ngocphan871/GATEWAY_AVIET_V1/Core/Inc/main.h

#define RELAY1_Pin GPIO_PIN_2
#define RELAY1_GPIO_Port GPIOE
#define RELAY2_Pin GPIO_PIN_3
#define RELAY2_GPIO_Port GPIOE
#define INPUT1_Pin GPIO_PIN_4
#define INPUT1_GPIO_Port GPIOE
#define INPUT2_Pin GPIO_PIN_5
#define INPUT2_GPIO_Port GPIOE
#define INPUT3_Pin GPIO_PIN_6
#define INPUT3_GPIO_Port GPIOE
#define RS485_DE_Pin GPIO_PIN_2
#define RS485_DE_GPIO_Port GPIOA
#define FLASH_CS_Pin GPIO_PIN_4
#define FLASH_CS_GPIO_Port GPIOA
#define FLOW1_Pin GPIO_PIN_0
#define FLOW1_GPIO_Port GPIOB
#define FLOW1_EXTI_IRQn EXTI0_IRQn
#define FLOW2_Pin GPIO_PIN_1
#define FLOW2_GPIO_Port GPIOB
#define FLOW2_EXTI_IRQn EXTI1_IRQn
#define TFT_RESET_Pin GPIO_PIN_12
#define TFT_RESET_GPIO_Port GPIOB
#define TFT_DC_Pin GPIO_PIN_14
#define TFT_DC_GPIO_Port GPIOB
#define TFT_CS_Pin GPIO_PIN_8
#define TFT_CS_GPIO_Port GPIOD
#define TFT_LED_Pin GPIO_PIN_9
#define TFT_LED_GPIO_Port GPIOD
#define RF_VCC1_Pin GPIO_PIN_9
#define RF_VCC1_GPIO_Port GPIOC
#define RF_BUSY_Pin GPIO_PIN_8
#define RF_BUSY_GPIO_Port GPIOA
#define RF_DIO1_Pin GPIO_PIN_9
#define RF_DIO1_GPIO_Port GPIOA
#define RF_VCC2_Pin GPIO_PIN_10
#define RF_VCC2_GPIO_Port GPIOA
#define RF_NSS_Pin GPIO_PIN_15
#define RF_NSS_GPIO_Port GPIOA
#define RF_DIO2_Pin GPIO_PIN_0
#define RF_DIO2_GPIO_Port GPIOD
#define RF_NRST_Pin GPIO_PIN_1
#define RF_NRST_GPIO_Port GPIOD
#define SIM_NETSTATUS_Pin GPIO_PIN_2
#define SIM_NETSTATUS_GPIO_Port GPIOD
#define SIM_STATUS_Pin GPIO_PIN_3
#define SIM_STATUS_GPIO_Port GPIOD
#define SIM_RESET_Pin GPIO_PIN_4
#define SIM_RESET_GPIO_Port GPIOD
#define SIM_PWRKEY_Pin GPIO_PIN_7
#define SIM_PWRKEY_GPIO_Port GPIOD
#define LED_Y4_Pin GPIO_PIN_3
#define LED_Y4_GPIO_Port GPIOB
