ngocphan871/GATEWAY_AVIET_V1/(commit log)

2026-10-19 add schematic pdf
2026-10-19 Firmware gateway V1: driver cho toan bo board + ung dung
    Cau hinh CubeMX (.ioc va code sinh ra) sua cho khop so do 2_GETWAY_V1:
    - Clock HSE 8 MHz -> PLL 168 MHz (truoc la HSI 16 MHz, HSE khai 25 MHz)
    - PB0/PB1 doi tu ADC sang EXTI dem xung cam bien luu luong YF-S201C
    - Dat ten chan theo so do, them PA4 lam FLASH_CS, bat ngat UART
    - RS485 9600, heap/stack 4 KB
    Code ung dung trong App/:
    - serial: 3 UART nhan bang ngat, printf ra USART1 + ban sao log trong RAM
    - board: relay, dau vao opto, LED, dem luu luong; IN1->RELAY1, IN2->RELAY2
    - modbus: Modbus RTU master tren RS485
    - ec800m: bat module bang AT (chan STATUS khong dung duoc), MQTT, goi, SMS
    - sx1262: LoRa, module S62F dung TCXO qua DIO3
    -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
2026-10-20 LoRa: lam viec voi node NODE_AVIET_V1; RTC chay LSE, lay gio mang 4G
    LoRa:
    - Module that la AcSiP S68F (SX1268): TCXO 3.0 V (0x06), RX boosted, #error neu
    tan so ngoai 433..510 MHz (driver chep tu repo node)
    - lora_node.c: hang doi goi (goi ca trong mdm_idle khi 4G dang chan), publish
    <base>/<IMEI>/node/<id> kem rssi/snr, goi la -> /lora dang hex
    - Lenh MQTT {"node":"<id>","cmd":"..."} -> "@<id> ..." qua LoRa
    - Bang node: dem mat goi theo n, offline sau 190 s -> {"id":..,"online":0}
    - Gui "@<id> time ..." cho node moi / node khoi dong lai / moi 6 gio
    - Console: node <id> <lenh>, nodes; TFT hien so node online; JSON gateway them "nodes"
    Da thu voi node 349CE1DF: RSSI -54..-60 dBm, khong m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
2026-10-27 tools: xem du lieu node va gui lenh qua ST-Link (khong can USB-TTL)
    - swd_common.ps1: ham chung doc dbg_log/dbg_log_pos va ghi swd_cmd qua
    STM32_Programmer_CLI; Send-SwdCmd cho gateway lay lenh truoc roi moi ghi
    (vong lap chinh co the bi 4G giu hang chuc giay, ghi de se mat lenh)
    - nodewatch.ps1: theo doi lien tuc, giai ma goi JSON cua node (nhiet do,
    do am, pin, sac, mua, IN/RELAY, luu luong, RSSI/SNR); -Node, -Raw, -NoHistory
    - sendcmd.ps1: gui 1 lenh console va in phan log moi
    - readlog.ps1: in 4 KB log cuoi
    - README: cach dung cac script va danh sach topic MQTT
2026-10-27 Them thu muc DATASHEET: tai lieu linh kien cua board
    STM32F407VET6, EC800M-CN (hardware design, spec, reference design), S68F (spec, application note, brief, EK user guide), W25Q32JV, MAX3485, cam bien mua ES-RAIN-02.
